noderockets/launcher/docs/README.md

NodeRocket Logo

# NodeRocket Launcher

- [Overview](overview.md)
- [Launcher Circuit Board](circuit-board.md)
- [Particle Photon](particle.md)
- [Building an Application](application.md)
- [Using NodeJS](using-nodejs.md)
- [Sample Applications](sample-apps.md)
