noderockets/launcher/docs/images/air_cylinder.png

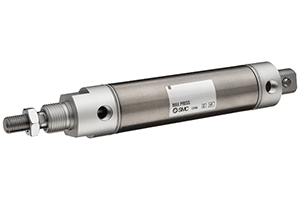
docs/images/air_cylinder.png
