noderockets/launcher/docs/images/board.jpg

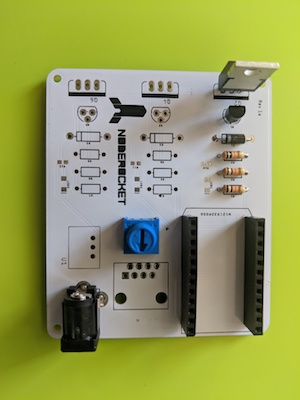
docs/images/board.jpg
