noderockets/launcher/(commit log)

2018-08-17 calculate pressure
2018-08-17 fix params to calc pressure
    [launcher.ino]
2018-08-21 added info about circuit board
2018-08-21 added image about circuit board
